syacct/Robo-DC-DC-Design/LM5143/LM(2)5143-Q1-dataDesign-19vout.xlsm

Sheet: Design Regulator
LM(2)5143/-Q1 Synchronous Buck Controller Design Tool
 |  |  |  |  |  |  |  |  |  |  |  |  | http://www.ti.com/product/lm5175
About |  | xx (http://www.ti.com/pol) |  |  | = Input Box |  |  |  |  |  |  |  | TERMS OF USE
Step 1: Operating Specifications
 |  |  | Input Voltage – Min, VIN(min) | 24 | V
 |  |  | Input Voltage – Nom, VIN(nom) | 48 | V
 |  |  | Input Voltage – Max, VIN(max) | 54 | V
 |  |  | Output Voltage, VOUT | 24 | V |  |  | Output Voltage, VOUT2 | 24 | V
 |  |  | Full Load Output Current, IOUT | 20 | A |  |  | Full Load Output Current, IOUT2 | 20 | A
 |  |  | Switching Frequency, FSW | 200 | kHz
 |  |  | Frequency Set Resistor, RT | 110 | kΩ
 |  |  | Ambient Temperature, TA | 25 | °C
Step 2: Current Sense Resistors
 |  |  | Required IOCP Setpoint at VIN(nom) | 16 | A |  |  | Required IOCP Setpoint at VIN(nom) | 16 | A
 |  |  | Recommended Sense Resistance | 6.6 | mΩ |  |  | Recommended Sense Resistance | 3.8 | mΩ
 |  |  | Sense Resistance, RS | 2 | mΩ |  |  | Sense Resistance, RS2 | 2 | mΩ
 |  |  | Min Inductor Sat Current, ILO(SAT) | 36.5 | A |  |  | Min Inductor Sat Current, ILO2(SAT) | 36.5 | A
 |  |  | Max power loss in shunt | 2.66 | W |  |  | Max power loss in shunt RS2 | 2.66 | W
 |  |  | VIN(min) | 73.0 | A |  |  | VIN(min) | 36.5 | A
 |  | IOUT(typ) at OCP Inception: | VIN(nom) | 67.0 | A |  | IOUT2(typ) at OCP Inception: | VIN(nom) | 33.5 | A
 |  |  | VIN(max) | 66.3 | A |  |  | VIN(max) | 33.2 | A
Step 3: Buck Inductances
 |  |  | Ch1 Recommended Inductance | 10.00 | µH |  |  | Ch2 Recommended Inductance | 10.00 | µH
 |  |  | Ch1 Inductance, LO1 | 10 | µH |  |  | Ch2 Inductance, LO2 | 10 | µH
 |  |  | Ch1 Inductor DCR | 3.5 | mΩ |  |  | Ch2 Inductor DCR | 3.5 | mΩ
 |  |  | DIL as a % at VIN(nom) | 60.11245314 | % |  |  | DIL2 as a % at VIN(nom) | 30.11240633 | %
Step 4: Output Capacitors
 |  |  | Output Voltage Ripple Spec | 70 | mVpk-pk |  |  | Ch2 Output Voltage Ripple Spec | 50 | mVpk-pk
 |  |  | Minimum Output Capacitance | 53.7 | µF |  |  | Ch2 Minimum Output Capacitance | 75.3 | µF
 |  |  | Output Capacitance (derated), COUT | 900 | µF |  |  | Ch2 Output Cap (derated), COUT2 | 490 | µF | ** For Single-Output Operation in 2-Phase Mode, tie MODE to VDDA and use FB1 to set VOUT **
 |  |  | Maximum Permitted ESR | 11.62411651 | mΩ |  |  | Ch2 Maximum Permitted ESR | 8.203659474 | mΩ
 |  |  | Output Capacitor ESR | 10 | mΩ |  |  | Ch2 Output Capacitor ESR | 2 | mΩ | ** Tie VCCX to GND if not used **
 |  |  | Resulting Output Voltage Ripple (max) | 60.25722589 | mVpk-pk |  |  | Resulting Output Voltage Ripple (max) | 14.28601397 | mVpk-pk
 |  |  | Output Capacitor RMS Current (max) | 1.93 | A (rms) |  |  | Output Capacitor RMS Current (max) | 1.93 | A (rms)
Step 5: Input Capacitors
 |  |  | Input Voltage Ripple Spec | 100 | mVpk-pk
 |  |  | Minimum Input Capacitance | 250 | µF
 |  |  | Input Capacitance, CIN | 440 | µF
 |  |  | Maximum Permitted ESR | 5.4 | mΩ
 |  |  | Input Capacitor ESR | 1 | mΩ
 |  |  | Resulting Input Voltage Ripple (max) | 41.74882619 | mVpk-pk
 |  |  | Input Capacitor RMS Current (max) | 5.00 | A (rms)
Step 6: Soft-start, Hiccup, Dither, DEMB, MODE
 |  |  | Soft-Start Time, tSS | 15 | ms
 |  |  | Soft-Start Capacitance, CSS | 470 | nF
 |  |  | Hiccup Fault Time, tRES | 30 | ms
 |  |  | RES Capacitance, CRES | 470 | nF
 |  |  | Modulating Frequency | 9
 |  |  | *Tie DITH to VDDA
 |  |  | * Tie DEMB to VDDA
 |  |  | * Tie MODE to VDDA
Step 7: Compensation Design
 |  |  | Load Pole Frequency | 236.3451179 | Hz |  |  | Ch2 Load Pole Frequency | 352.0818137 | Hz
 |  |  | ESR Zero Frequency | 17.68388259 | kHz |  |  | Ch2 ESR Zero Frequency | 162.4030033 | kHz
 |  |  | Desired Crossover Frequency | 20 | kHz |  |  | Ch2 Desired Crossover Frequency | 20 | kHz
 |  |  | Error Amp Pole Frequency | 1.4 | Hz |  |  | Ch2 Error Amp Pole Frequency | 1.7 | Hz
 |  |  | Upper Feedback Resistor | 51 | kΩ |  |  | Ch2 Upper Feedback Resistor | 51 | kΩ
 |  |  | Lower Feedback Resistor | 1.3 | kΩ |  |  | Ch2 Lower Feedback Resistor | 1.3 | kΩ
Compensation Components
 | Calculated / | Std Values | Std Values |  | Actual P/Z Frequencies
RC1 | 45.2 | 45.3 | 45.3 | kΩ | 1.380576138 | Hz (FPEA)
CC1 | 1.8 | 1.8 | 1.8 | nF | 2.0 | kHz (FZCOMP)
CC2 | 192.5774814 | 180 | 180 | pF | 18.85188515 | kHz (FPCOMP)
RC2 | 49.3 | 48.7 | 48.7 | kΩ | 1.656603421 | Hz (FPEA2)
CC3 | 1.6 | 1.5 | 1.5 | nF | 2.2 | kHz (FZCOMP2)
CC4 | 25.94285325 | 27 | 27 | pF | 97.94549192 | kHz (FPCOMP2) |  |  |  |  |  | ** Specify Inductor Core Loss ** | 0.3 | W
Efficiency / Power Loss Analyzer
Step 8: Efficiency
 |  |  |  |  | Power MOSFETs | (Q1, Q2) |  | Power MOSFETs | (Q3, Q4)
 |  |  |  | NVMFS5H663, NVMFS5C628NL |  |  | NVMFS5H663, NVMFS5C628NL
 |  |  |  | High-side | Low-side |  | High-side | Low-side
 |  |  | On-State Resistance, RDS(on) | 2.5 | 2.5 | mΩ | 6 | 2.5 | mΩ
 |  |  | Total Gate Charge, QG | 45 | 45 | nC | 8 | 25 | nC
 |  |  | Gate-Drain Charge, QGD | 15 | 15 | nC | 1.4 | 4.5 | nC
 |  |  | Gate-Source Charge, QGS | 16 | 16 | nC | 3.8 | 12 | nC
 |  |  | Output Charge, QOSS |  | 88 | nC |  | 30 | nC
 |  |  | Output Capacitance, COSS | 840 | 840 | pF | 213 | 1700 | pF
 |  |  | Gate Resistance, RG | 1.7 | 1.7 | Ω | 0.5 | 0.5 | Ω
 |  |  | Transconductance, gFS | 140 | 140 | S | 64 | 280 | S
 |  |  | Gate-Source Threshold Voltage, VTH | 1.7 | 1.7 | V | 2.9 | 3 | V
 |  |  | Body Diode Forward Voltage, VBD | 0.85 | 0.85 | V | 0.7 | 0.7 | V
 |  |  | Body Diode Rev Recovery Charge, QRR |  | 47 | nC |  | 60 | nC
 |  |  | Thermal Resistance, θJA | 50 | 50 | °C/W | 50 | 38 | °C/W
External Schottky Diode (if applicable)
 |  |  | Schottky Fwd Voltage, VFWDsch | 0 | 0 | V
 |  |  | Schottky Rev Recovery Charge, QRRsch | 0 | 0 | nC
Step 9: IC Power Loss
 |  |  | IC Power Dissipation | 0.18 | W
 |  |  | IC Junction Temperature (estimate) | 31.3 | °C

Sheet: BOM & Schematic
** Tie DEMB to VDDA for FPWM, AGND for DCM ** |  |  |  |  |  | ** Tie VCCX to GND if not used **
** Tie MODE to VDDA for Single, AGND for Dual Outputs **
** For Dual-Output Operation, tie FB1/FB2 to to VDDA for Fixed 3.3V, AGND for Fixed 5V Output **
** For Single-Output Operation in 2-Phase Mode, tie MODE to VDDA and use FB1 to set VOUT. Connect FB2 to AGND to disable EA of channel 2 **
** For Single-Output Operation in 3-Phase or 4-Phase Mode, tie all MODE pins to VDDA. Use FB1 of master IC to set VOUT. Connect FB2 of master IC to AGND. Connect FB2 of slave IC to VDDA to configure it as a slave **
VIN = 24 V to 54 V, VOUT = 24 V, IOUT = 20 A, Fsw = 200 kHz, Current Limit = 16 A
High Efficiency Synchronous Buck Regulator BOM
Count | Ref Des | Value | Description |  | Size | Part Number | MFR
2 | CBOOT1, CBOOT2 | 0.1µF | Capacitor, Ceramic,0.1-µF, 25V, X7R, 20% |  | 0603 | Std | Std
1 | CC1 | 1.8nF | Capacitor, Ceramic,1.8-nF, 16V, X7R, 10% |  | 0603 | Std | Std
1 | CC2 | 180pF | Capacitor, Ceramic,180-pF, 50V, NP0, 5% |  | 0603 | Std | Std
1 | CC3 | N/A | N/A |  | - | - | -
1 | CC4 | N/A | N/A |  | - | - | -
1 | CRES | 470nF | Capacitor, Ceramic,470-nF, 16V, X7R, 10% |  | 0603 | Std | Std
1 | CDITH | 10nF | Capacitor, Ceramic,10-nF, 16V, X7R, 10% |  | 0603 | Std | Std
44 | CIN | 10µF | Capacitor, Ceramic,10-µF, 50V, X7R, 20% |  | 1210 | Std | Std
20 | COUT | 47µF | Capacitor, Ceramic,47-µF, 10V, X7R, 20% |  | 1210 | Std | Std
2 | CSS1, CSS2 | 470nF | Capacitor, Ceramic,470-nF, 16V, X7R, 10% |  | 0603 | Std | Std
3 | CVCC1, CVCC2, CVCCX | 2.2µF | Capacitor, Ceramic,2.2-µF, 25V, X7R, 20% |  | 0603 | Std | Std
1 | CVDDA | 0.47µF | Capacitor, Ceramic,0.47-µF, 25V, X7R, 20% |  | 0603 | Std | Std
2 | DBOOT1, DBOOT2 | See description | Schottky Diode, 60V, 200mA |  | - | - | Various
1 | LO1 | 10µH | Inductor, 10µH, 3.5mΩ, >11A |  | - | - | Various
1 | LO2 | 10µH | Inductor, 10µH, 3.5mΩ, >11A |  | - | - | Various
2 | Q1, Q2 | See description | MOSFET, N-CH, 40V,2.5mΩ |  | Std | NVMFS5H663, NVMFS5C628NL | -
2 | Q3, Q4 | See description | MOSFET, N-CH, 40V,6mΩ |  | Std | NVMFS5H663, NVMFS5C628NL | -
1 | RC1 | 45.3k | Resistor, Chip,45.3-kΩ, 1/16W, 1% |  | 0603 | Std | Std
1 | RC2 | N/A | N/A |  | - | - | -
1 | RS1 | 2m | Resistor, Chip,2-mΩ, 2W, 1% |  | 0508 | Std | Std
1 | RS2 | 2m | Resistor, Chip,2-mΩ, 2W, 1% |  | 0508 | Std | Std
1 | RT | 110k | Resistor, Chip,110-kΩ, 1/16W, 1% |  | 0603 | Std | Std
1 | RFB1 | 51k | Resistor, Chip,51-kΩ, 1/16W, 1% |  | 0603 | Std | Std
1 | RFB2 | 1.3k | Resistor, Chip,1.3-kΩ, 1/16W, 1% |  | 0603 | Std | Std
1 | RFB3 | N/A | N/A |  | - | - | -
1 | RFB4 | N/A | N/A |  | - | - | -
2 | RPGOOD1, RPGOOD2 | 100k | Resistor, Chip,100-kΩ, 1/16W, 1% |  | 0603 | Std | Std
2 | RPG1, RPG2 | 100k | Resistor, Chip,100-kΩ, 1/16W, 1% |  | 0603 | Std | Std
1 | RDEMB | 100k | Resistor, Chip,100-kΩ, 1/16W, 1% |  | 0603 | Std | Std
1 | RVIN | 2.2 | Resistor, Chip,2.2-Ω, 1/16W, 1% |  | 0603 | Std | Std
1 | U1 | LM5143 | IC, LM5143, Buck PWM Controller, 3.5V–65V Input |  | VQFN-40 | LM5143RHAR | TI
NOTES:
** For information on TI NexFETTM MOSFETs, see ** |  |  | http://www.ti.com/nexfet | **
** Inductor saturation current should be higher than the peak inductor current at the OCP setpoint for all input voltages and operating temperatures **
** Effective input and output capacitances should be appropriately derated for applied voltage and temperature, particularly with ceramics **

Sheet: EVM
LM(2)5143/-Q1 Quickstart Design Tool
 | LM5143-Q1EVM-2100 PCB Layout
