syacct/Robo-DC-DC-Design/LM5145/LM5145contorller-dataDesign-48to24v.xlsm

Sheet: Design Regulator
LM(2)5145/46-Q1 DC-DC Controller Design Tool
About |  | xx (http://www.ti.com/pol) |  |  | = Input Box |  |  |  |  | TERMS OF USE
Step 1: Operating Specifications
 |  |  | Input Voltage ‒ Min, VIN(min) | 40 | V
 |  |  | Input Voltage ‒ Nom, VIN(nom) | 48 | V
 |  |  | Input Voltage ‒ Max, VIN(max) | 60 | V
 |  |  | Output Voltage, VOUT | 24.7 | V
 |  |  | Maximum Output Current, IOUT | 20 | A
 |  |  | Free-running Switching Frequency, FSW | 120 | kHz
 |  |  | SYNC Frequency (if used), FSW-SYNC |  | kHz
 |  |  | Frequency Set Resistor, RRT | 82.5 | kΩ
Step 2: Filter Inductor
 |  |  | Recommended Filter Inductance | 15.0 | µH
 |  |  | Inductance, LF | 10 | µH
 |  |  | Inductor DCR | 2 | mΩ
 |  |  | Pk-to-Pk Ripple Current at VIN(nom), DIL | 10.0 | Apk-pk
 |  |  | Inductor Ripple Current as a % of Max IOUT | 50.16926459 | %
Step 3: RDS(on) or Shunt-Based Current Limit
 |  |  | Shunt, RS | 6 | mΩ |  |  |  |  |  | \
 |  |  | Required Current Limit Setpoint | 20 | A
 |  |  | Current Limit Set Resistor, RILIM | 215 | Ω
 |  |  | Min Inductor Sat Current, IL(SAT) | 30.0 | A
 |  |  | Power Loss in RS at Full Load, Max VIN | 0.83 | W
Step 4: Output Capacitance
 |  |  | Output Voltage Ripple Specification | 100 | mVpk-pk
 |  |  | Minimum Ideal Output Capacitance | 104.5193012 | µF
 |  |  | Total Output Capacitance (Derated), COUT | 457.5 | µF
 |  |  | Maximum Permitted ESR | 9.702692449 | mΩ
 |  |  | Output Capacitor ESR | 1 | mΩ
 |  |  | Resulting Output Voltage Ripple | 24.95208303 | mVpk-pk
 |  |  | Output Capacitor Ripple Current | 2.9 | A (rms)
Step 5: Input Capacitance
 |  |  | Input Voltage Ripple Specification | 480 | mVpk-pk
 |  |  | Minimum Ideal Input Capacitance | 86.70796396 | µF
 |  |  | Total Input Capacitance (Derated), CIN | 117.5 | µF
 |  |  | Maximum Permitted ESR | 5.028145371 | mΩ
 |  |  | Input Capacitor ESR | 1 | mΩ
 |  |  | Resulting Input Voltage Ripple | 379.2281835 | mVpk-pk
 |  |  | Input Capacitor Ripple Current | 10.0 | A (rms)
Step 6: Soft-start, UVLO
 |  |  | Soft-Start Time, tSS | 35 | ms
 |  |  | Soft-Start Capacitance, CSS | 470 | nF
 |  |  | Input Voltage UVLO Turn-On | 32.5 | V
 |  |  | Input Voltage UVLO Turn-Off | 30.5 | V
 |  |  | UVLO Upper Resistor, RUV1 | 200 | kΩ
 |  |  | UVLO Lower Resistor, RUV2 | 7.68 | kΩ
If the SYNC feature is not required, connect SYNCIN to GND
or VCC for DCM or CCM operation, respectively
Step 7: Compensation Design
 |  |  | LC Complex Pole Frequency | 2.4 | kHz
 |  |  | ESR Zero Frequency | 347.8796574 | kHz
 |  |  | Desired Crossover Frequency | 8 | kHz
 |  |  | Appropriate Midband Gain | 0.23 | V/V
 |  |  | Upper Feedback Resistor, RFB1 | 300 | kΩ
 |  |  | Lower Feedback Resistor, RFB2 | 10 | kΩ
 |  |  | Actual Output Voltage, VOUT | 24.800 | V
Pole & Zero Placement |  |  | FZ1 | 1.6 | kHz
Baseline P/Z Frequencies: |  |  | FZ2 | 2.1 | kHz
 |  |  | FP1 | 347.8796574 | kHz
 |  |  | FP2 | 60 | kHz
Compensation Components
 | Calculated / | Std Values | Selected |  | Actual P/Z Frequencies
RC1 | 68.0 | 68.1 | 68.1 | kΩ | 1.6 | kHz (FZ1)
CC1 | 1421.026279 | 1500 | 1500 | pF | 2.0 | kHz (FZ2)
CC2 | 40.12757695 | 39 | 39 | pF | 327.4793071 | kHz (FP1)
RC2 | 1838.179194 | 1820 | 1800 | Ω | 61.48310245 | kHz (FP2)
CC3 | 248.8875956 | 270 | 270 | pF |  |  | ** Specify Inductor Core Loss ** | 0.5 | W
Efficiency / Power Loss Analyzer
Step 8: Efficiency
 |  |  | High-Side MOSFET (Q1) Specifications | CSD19534Q5A*2
 |  |  | On-State Resistance, RDS(on) | 3.55 | mΩ
 |  |  | Total Gate Charge, QG | 22 | nC
 |  |  | Gate-Drain Charge, QGD | 7.8 | nC
 |  |  | Gate-Source Charge, QGS | 8.6 | nC
 |  |  | Output Capacitance, COSS | 440 | pF
 |  |  | Gate Resistance, RG | 0.6 | Ω
 |  |  | Transconductance, gFS | 94 | S
 |  |  | Gate-Source Threshold Voltage, VGS(TH) | 1.6 | V
 |  |  | Body Diode Forward Voltage, VBD1 | 0.86 | V
 |  |  | Thermal Resistance, θJA | 25 | °C/W
 |  |  | Low-Side MOSFET (Q2) Specifications | CSD19502Q5B
 |  |  | On-State Resistance, RDS(on) | 2.9 | mΩ
 |  |  | Total Gate Charge, QG | 70 | nC
 |  |  | Output Charge, QOSS | 91 | nC
 |  |  | Output Capacitance, COSS | 770 | pF
 |  |  | Body Diode Forward Voltage, VBD2 | 0.82 | V
 |  |  | Body Diode Recovery Charge, QRR | 122 | nC
 |  |  | Thermal Resistance, θJA | 50 | °C/W
 |  |  | Antiparallel Schottky Diode (if applicable)
 |  |  | Schottky Diode Forward Voltage, VSD | 0.64 | V
 |  |  | Schottky Diode Recovery Charge, QRR2 | 100 | nC

Sheet: Schematic & BOM
 | ** Tie SYNCIN to VCC and GND for CCM and DCM operation, respectively **
VIN = 48 V, VOUT = 24.7 V, IOUT = 20 A, Fsw = 120 kHz, Current Limit = 20 A
Wide VIN, High Efficiency Synchronous Buck Regulator BOM
Count | Ref Des | Value | Description | Size | Part Number | MFR | Footprint (mm) | Area (mm2)
1 | CBOOT | 0.1µF | Capacitor, Ceramic,0.1µF, 25V, X7R, 20% |  | Std | Std | 1.6 x 0.8 | 1.3 |  |  |  | 2
1 | CC1 | 1500pF | Capacitor, Ceramic,1500pF, 16V, X7R, 10% |  | Std | Std | 1.0 x 0.5 | 0.5 |  |  |  | 1
1 | CC2 | 39pF | Capacitor, Ceramic,39pF, 50V, NP0, 5% |  | Std | Std | 1.0 x 0.5 | 0.5 |  |  |  | 1
1 | CC3 | 270pF | Capacitor, Ceramic,270pF, 50V, NP0, 5% |  | Std | Std | 1.0 x 0.5 | 0.5 |  |  |  | 1
1 | CS | 27pF | Capacitor, Ceramic, 27pF, 100V, X7R, 20% |  | Std | Std | 1.6 x 0.8 | 1.3 |  |  |  | 2
12 | CIN | 4.7µF | Capacitor, Ceramic, 4.7µF, 100V, X7S, 10% |  | Std | Std | 3.2 x 2.5 | 96.0 |  |  |  | 5
46 | COUT | 10µF | Capacitor, Ceramic, 10µF, 50V, X7R, 10% |  | Std | Std | 3.2 x 2.5 | 368.0 |  |  |  | 5
1 | CSS | 470nF | Capacitor, Ceramic,470nF, 16V, X7R, 10% |  | Std | Std | 1.6 x 0.8 | 1.3 |  |  |  | 2
1 | CVCC | 2.2µF | Capacitor, Ceramic,2.2µF, 25V, X7R, 20% |  | Std | Std | 2.0 x 1.25 | 2.5 |  |  |  | 3
1 | CVIN | 0.1µF | Capacitor, Ceramic,0.1µF, 50V, X7R, 20% |  | Std | Std | 1.6 x 0.8 | 1.3 |  |  |  | 2
1 | LF | 10µH | Inductor, 10µH, 2mΩ, >30A |  | Various | Various | 10.0 x 10.0 | 100.0 |  |  |  | 7
1 | Q1 | See description | MOSFET, N-CH, 80V/100V,3.55mΩ |  | CSD19534Q5A*2 | TI | 5.0 x 6.0 | 30.0 |  |  |  | 1 | 1
1 | Q2 | See description | MOSFET, N-CH, 80V/100V,2.9mΩ |  | CSD19502Q5B | TI | 5.0 x 6.0 | 30.0 |  |  |  | 1 | 1
1 | RC1 | 68.1k | Resistor, Chip,68.1kΩ, 1/16W, 1% |  | Std | Std | 1.0 x 0.5 | 0.5 |  |  |  | 1
1 | RC2 | 1800 | Resistor, Chip,1800Ω, 1/16W, 1% |  | Std | Std | 1.0 x 0.5 | 0.5 |  |  |  | 1
1 | RILIM | 215 | Resistor, Chip,215Ω, 1/16W, 1% |  | Std | Std | 1.0 x 0.5 | 2.5 |  |  |  | 3
1 | RRT | 82.5k | Resistor, Chip,82.5kΩ, 1/16W, 1% |  | Std | Std | 1.0 x 0.5 | 0.5 |  |  |  | 1
1 | RFB1 | 300k | Resistor, Chip,300kΩ, 1/16W, 1% |  | Std | Std | 1.0 x 0.5 | 0.5 |  |  |  | 1
1 | RFB2 | 10k | Resistor, Chip,10kΩ, 1/16W, 1% |  | Std | Std | 1.0 x 0.5 | 0.5 |  |  |  | 1
1 | RPGOOD | 20k | Resistor, Chip,20kΩ, 1/16W, 1% |  | Std | Std | 1.0 x 0.5 | 0.5 |  |  |  | 1
1 | RS | 6mΩ | Resistor,6mΩ, 1/4W, 1% | 1206 | Std | Std | 3.2 x 1.6 | 0.0
1 | RUV1 | 200k | Resistor, Chip,200kΩ, 1/16W, 1% |  | Std | Std | 1.6 x 0.8 | 1.3 |  |  |  | 2
1 | RUV2 | 7.68k | Resistor, Chip,7.68kΩ, 1/16W, 1% |  | Std | Std | 1.0 x 0.5 | 0.5 |  |  |  | 1
1 | RVIN | 2.2 | Resistor, Chip,2.2Ω, 1/16W, 1% |  | Std | Std | 1.0 x 0.5 | 0.5 |  |  |  | 1
1 | U1 | LM5145 | IC, LM5145, PWM Controller, 6V-75V Input | VQFN-20 | LM5145RGYR | TI | 3.5 x 4.5 x 1.0 | 15.75
 |  |  |  |  | Total Solution Size (buffered by 25%) |  |  | 820.9 | mm2 = | 1.2725 | in2
NOTES:
** Inductor saturation current should be higher than the current limit setpoint at all operating temperatures **
** Effective output capacitance should be appropriately derated for applied voltage and temperature, particularly with ceramics **
 |  |  |  |  |  |  |  |  |  |  |  | 2

Sheet: EVMs
LM(2)5145/6/-Q1 Quickstart Calculator
 | LM5146-Q1-EVM12V
 | LM5145EVM-HD-20A PCB Layout
 |  | Top
 |  | Layer | x
 |  | Layer 2
 |  | Layer 3
 |  | Bottom
