syacct/Robo-DC-DC-Design/LM5176/LM5176_Buck-Boost_dataDesign_19vout.xlsm

Sheet: Design Converter
LM5176 DC/DC Controller Design Tool
 |  |  |  |  |  |  |  |  |  |  |  | http://www.ti.com/product/lm5176
About |  | xx (http://www.ti.com/pol) |  |  | = Input Box |  |  |  |  |  |  | TERMS OF USE
Step 1: Operating Specifications |  |  |  |  |  |  |  |  | V 1.0.2 | February 2026
 |  |  | Input Voltage - Min, VIN(min) | 12 | V
 |  |  | Input Voltage - Nom, VIN(nom) | 24 | V
 |  |  | Input Voltage - Max, VIN(max) | 36 | V
 |  |  | Output Voltage, VOUT | 19 | V
 |  |  | Full Load Output Current, IOUT(max) | 8 | A
 |  |  | Switching Frequency | 300 | kHz
 |  |  | Frequency Set Resistor, RT | 27.4 | kΩ
Step 2: Filter Inductor
 |  |  | Recommended Filter Inductance | 4.1 | µH
 |  |  | Inductance, LF | 10 | µH
 |  |  | Inductor DCR | 10 | mΩ
 |  |  | Pk-to-Pk Ripple Current at VIN(min), DIL1 | 1.5 | Apk-pk
 |  |  | Pk-to-Pk Ripple Current at VIN(nom), DIL2 | 1.3 | Apk-pk
 |  |  | Pk-to-Pk Ripple Current at VIN(max), DIL3 | 3.0 | Apk-pk
 |  |  | DIL as a % at VIN(min) | 10.7211484 | %
 |  |  | DIL as a % at VIN(nom) | 16.56960621 | %
 |  |  | DIL as a % at VIN(max) | 37.57861635 | %
Step 3: OCP, Sense Resistors, Slope Comp
 |  |  | Required IOCP(MIN) Setpoint at VIN(nom) | 8 | A
 |  |  | Recommended Sense Resistance | 8.1 | mΩ
 |  |  | Sense Resistance, RS | 5 | mΩ
 |  |  | Peak Inductor Current, ILPK | 24.0 | A
 |  |  | Power Loss in Rs at Full Load (Min VIN) | 0.37 | W
 |  |  | Recommended SLOPE Capacitance | 820 | pF
 |  |  | SLOPE Capacitance, CSLOPE | 820 | pF
 |  |  | VIN(min) | 14.5 | A
 |  | IOUT(typ) at OCP Inception: | VIN(nom) | 16.7 | A
 |  |  | VIN(max) | 17.5 | A
 |  |  | Set Const Current Loop Setpoint (?) | 10 | A
 |  |  | Output Leg Shunt Resistance, RCS(out) | 5 | mΩ
Step 4: Output Capacitor
 |  |  | Output Voltage Ripple Spec | 150 | mVpk-pk
 |  |  | Minimum Output Capacitance | 67.1 | µF
 |  |  | Output Capacitance, COUT | 260 | µF
 |  |  | Maximum Permitted ESR | 13.9 | mΩ
 |  |  | Output Capacitor ESR | 2 | mΩ
 |  |  | Resulting Output Voltage Ripple (max) | 54.68980429 | mVpk-pk
 |  |  | Output Capacitor RMS Current (max) | 6.1 | A (rms)
 |  |  |  |  |  |  |  |  |  | VIN(nom) | 24V
Step 5: Input Capacitor
 |  |  | Input Voltage Ripple Spec | 200 | mVpk-pk
 |  |  | Minimum Input Capacitance | 33.2 | µF
 |  |  | Input Capacitance, CIN | 260 | µF
 |  |  | Maximum Permitted ESR | 18.4 | mΩ
 |  |  | Input Capacitor ESR | 10 | mΩ
 |  |  | Resulting Input Voltage Ripple (max) | 120.5769265 | mVpk-pk
 |  |  | Input Capacitor RMS Current (max) | 4.0 | A (rms)
Step 6: Soft-start, Dither, UVLO
 |  |  | Soft-Start Time, tSS | 7 | ms
 |  |  | Soft-Start Capacitance, CSS | 47 | nF
 |  |  | Modulating Frequency | 1
 |  |  | *Short DITH pin to GND
 |  |  | Required Input Voltage UVLO On | 9.5 | V
 |  |  | Input Voltage UVLO Off | 9.28 | V
 |  |  | Upper UVLO Resistor, RUV1 | 51 | kΩ
 |  |  | Lower UVLO Resistor, RUV2 | 7.5 | kΩ
Step 7: Compensation Design
 |  |  | Load Pole Frequency | 376.3346281 | Hz
 |  |  | COUT ESR Zero Frequency | 306.0671986 | kHz
 |  |  | Boost RHP Zero Frequency | 1.583233698 | kHz
 |  |  | Desired Crossover Frequency | 18 | kHz
 |  |  | Error Amp Pole Frequency | 0.3614446966 | Hz
 |  |  | Upper Feedback Resistor, RFB1 | 75 | kΩ
 |  |  | Lower Feedback Resistor, RFB2 | 3.32 | kΩ
Compensation Components
 | Calculated / | Std Values | Selected |  | Actual P/Z Frequencies
RC | 13.7 | 13.7 | 15 | kΩ | 0.3614446966 | Hz (FPEA) | Min COMP Voltage | 1.49V
CC1 | 20.5 | 22 | 22 | nF | 0.5 | kHz (FZCOMP) | Max COMP Voltage | 2V
CC2 | 66.61478276 | 68 | 68 | pF | 113.7643614 | kHz (FPCOMP)
Efficiency / Power Loss Analyzer
Step 8: Efficiency |  |  |  |  |  |  |  |  |  | VIN(nom) | 24V
 |  |  | Buck-Leg Power MOSFETs (Q1, Q2) | CSD18563Q5A
 |  |  |  | Hi-side | Low-side
 |  |  | On-State Resistance, RDS(on) | 7.0 | 7.0 | mΩ
 |  |  | Total Gate Charge, QG | 11 | 11 | nC
 |  |  | Gate-Drain Charge, QGD | 2.9 | 2.9 | nC
 |  |  | Gate-Source Charge, QGS | 3.3 | 3.3 | nC
 |  |  | Gate Resistance, RG | 1.5 | 1.5 | Ω
 |  |  | Transconductance, gFS | 60 | 60 | S
 |  |  | Gate-Source Threshold Voltage, VTH | 4 | 4 | V
 |  |  | Body Diode Forward Voltage, VBD | 0.8 | 0.8 | V
 |  |  | Body Diode Rev Recovery Charge, QRR |  | 63 | nC
 |  |  | Thermal Resistance, θJA | 50 | 50 | °C/W
 |  |  | Boost-Leg Power MOSFETs (Q3, Q4) | CSD16321Q5
 |  |  |  | Hi-side | Low-side
 |  |  | On-State Resistance, RDS(on) | 7 | 7 | mΩ
 |  |  | Total Gate Charge, QG | 22 | 22 | nC
 |  |  | Gate-Drain Charge, QGD | 2.5 | 2.5 | nC
 |  |  | Gate-Source Charge, QGS | 4 | 4 | nC
 |  |  | Gate Resistance, RG | 1.5 | 1.5 | Ω
 |  |  | Transconductance, gFS | 150 | 150 | S
 |  |  | Gate-Source Threshold Voltage, VTH | 2 | 2 | V
 |  |  | Body Diode Forward Voltage, VBD | 0.8 | 0.8 | V
 |  |  | Body Diode Rev Recovery Charge, QRR | 33 |  | nC
 |  |  | Thermal Resistance, θJA | 50 | 50 | °C/W
External Schottky Diode (if applicable) |  |  |  | Buck Leg | Boost Leg
 |  |  | Schottky Fwd Voltage, VFWDsch | 0 | 0 | V
 |  |  | Schottky Rev Recovery Charge, QRRsch | 0 | 0 | nC

Sheet: BOM & Schematic
 | ** Tie MODE to VCC (or voltage > 2.4V) for No Hiccup **
VIN = 12 V to 36 V, VOUT = 19 V, IOUT = 8 A, Fsw = 300 kHz, Current Limit = 8 A
High Efficiency Synchronous Buck-Boost Regulator BOM
Count | Ref Des | Value | Description |  | Size | Part Number | MFR
2 | CBOOT1, CBOOT2 | 0.1µF | Capacitor, Ceramic,0.1-µF, 50V, X7R, 20% |  | 0603 | Std | Std
1 | CC1 | 22nF | Capacitor, Ceramic,22-nF, 16V, X7R, 10% |  | 0603 | Std | Std
1 | CC2 | 68pF | Capacitor, Ceramic,68-pF, 50V, NP0, 5% |  | 0603 | Std | Std
1 | CSLOPE | 820pF | Capacitor, Ceramic,820-pF, 50V, NP0, 5% |  | 0603 | Std | Std
1 | CCS | 100pF | Capacitor, Ceramic,100-pF, 16V, X7R, 10% |  | 0603 | Std | Std
1 | CDITH | 39nF | Capacitor, Ceramic,39-nF, 16V, X7R, 10% |  | 0603 | Std | Std
26 | CIN | 10µF | Capacitor, Ceramic,10-µF, 50V, X7R, 20% |  | 1210 | Std | Std
12 | COUT | 22µF | Capacitor, Ceramic,22-µF, 25V, X5R, 20% |  | 1210 | Std | Std
1 | CSS | 47nF | Capacitor, Ceramic,47-nF, 16V, X7R, 10% |  | 0603 | Std | Std
1 | CVCC | 1µF | Capacitor, Ceramic,1-µF, 25V, X7R, 20% |  | 0603 | Std | Std
1 | CVIN | 0.1µF | Capacitor, Ceramic,0.1-µF, 100V, X7R, 20% |  | 0603 | Std | Std
3 | DBOOT1, DBOOT2, DVIN | See description | Schottky Diode, 200mA |  | - | - | Various
1 | LF | 10µH | Inductor, 10µH, 10mΩ, >27A |  | - | - | Various
2 | Q1, Q2 | See description | MOSFET, N-CH, 60V,7mΩ |  | Std | CSD18563Q5A | -
2 | Q3, Q4 | See description | MOSFET, N-CH, 60V,7mΩ |  | Std | CSD16321Q5 | -
1 | RC1 | 15k | Resistor, Chip,15-kΩ, 1/16W, 1% |  | 0603 | Std | Std
1 | RS | 5m | Resistor, Chip,5-mΩ, 2W, 1% |  | 2512 | Std | Std
1 | RCS(out) | 4.99m | Resistor, Chip,4.99-mΩ, 2W, 1% |  | 2512 | Std | Std
1 | RT | 27.4k | Resistor, Chip,27.4-kΩ, 1/16W, 1% |  | 0603 | Std | Std
1 | RFB1 | 75k | Resistor, Chip,75-kΩ, 1/16W, 1% |  | 0603 | Std | Std
1 | RFB2 | 3.32k | Resistor, Chip,3.32-kΩ, 1/16W, 1% |  | 0603 | Std | Std
1 | RPGOOD | 20k | Resistor, Chip,20-kΩ, 1/16W, 1% |  | 0603 | Std | Std
2 | RCS, RCSG | 100 | Resistor, Chip,100-Ω, 1/16W, 1% |  | 0603 | Std | Std
1 | RUV1 | 51k | Resistor, Chip,51-kΩ, 1/16W, 1% |  | 0603 | Std | Std
1 | RUV2 | 7.5k | Resistor, Chip,7.5-kΩ, 1/16W, 1% |  | 0603 | Std | Std
1 | RVIN | 2.2 | Resistor, Chip,2.2-Ω, 1/16W, 1% |  | 0603 | Std | Std
1 | U1 | LM5176 | IC, LM5176, Buck-Boost PWM Controller |  | TSSOP-28 | LM5176PWP | TI
NOTES:
** For information on TI NexFETTM MOSFETs, see ** |  |  | http://www.ti.com/nexfet | **
** Inductor saturation current should be higher than the peak inductor current at the OCP setpoint for all input voltages and operating temperatures **
** Effective input and output capacitances should be appropriately derated for applied voltage and temperature, particularly with ceramics **

Sheet: Licenses
Version Number | 1.0.2
Version History
Version | Change List Description
1.0.0 | Initial Release
1.0.1 | Fixed display of comments, optimized proposal of inductor
1.0.2 | Fixed calculation of Peak Inductor Current, ILPK
