syacct/Robo-DC-DC-Design/LM5176/LM5176.step

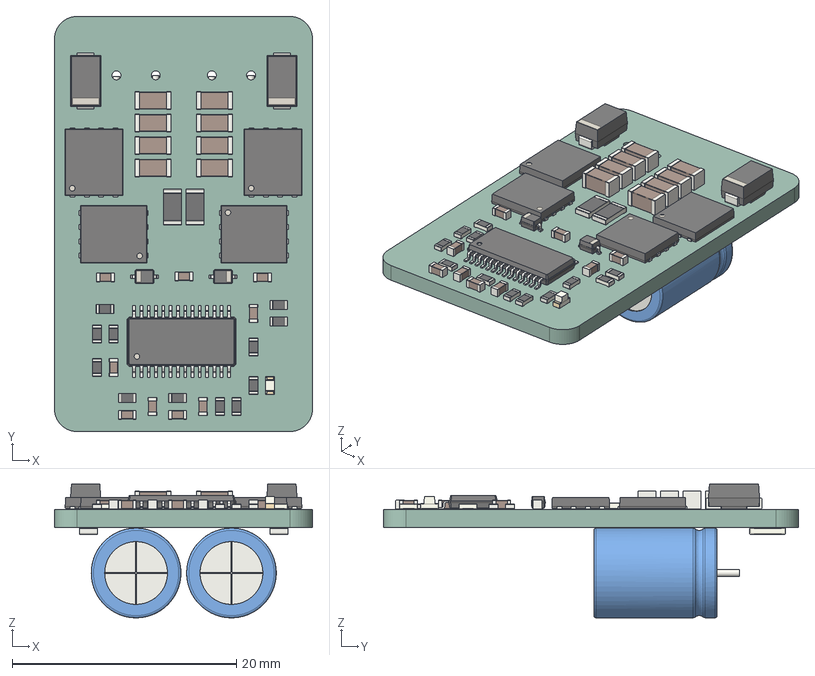
[picture p1: CAD file, 2026-10-31]
LM5176/LM5176.step
23.0 x 37.0 x 11.9 mm
C_1206_3216Metric x 8
R_0603_1608Metric x 12
D_SMA x 2
R_1206_3216Metric x 3
HTSSOP_28_1EP_44x97mm_P065mm
C_0603_1608Metric x 9
TDSON_8_1 x 4
D_SOD_323 x 2
LED_0603_1608Metric
C_Radial_D80mm_H115mm_P350mm x 2
Fuse_1206_3216Metric
LM5176_PCB
