syacct/Robo-DC-DC-Design/LM5145/LM5145_48-24.kicad_pcb

## KiCad design LM5145/LM5145_48-24.kicad_pcb (2026-10-31)

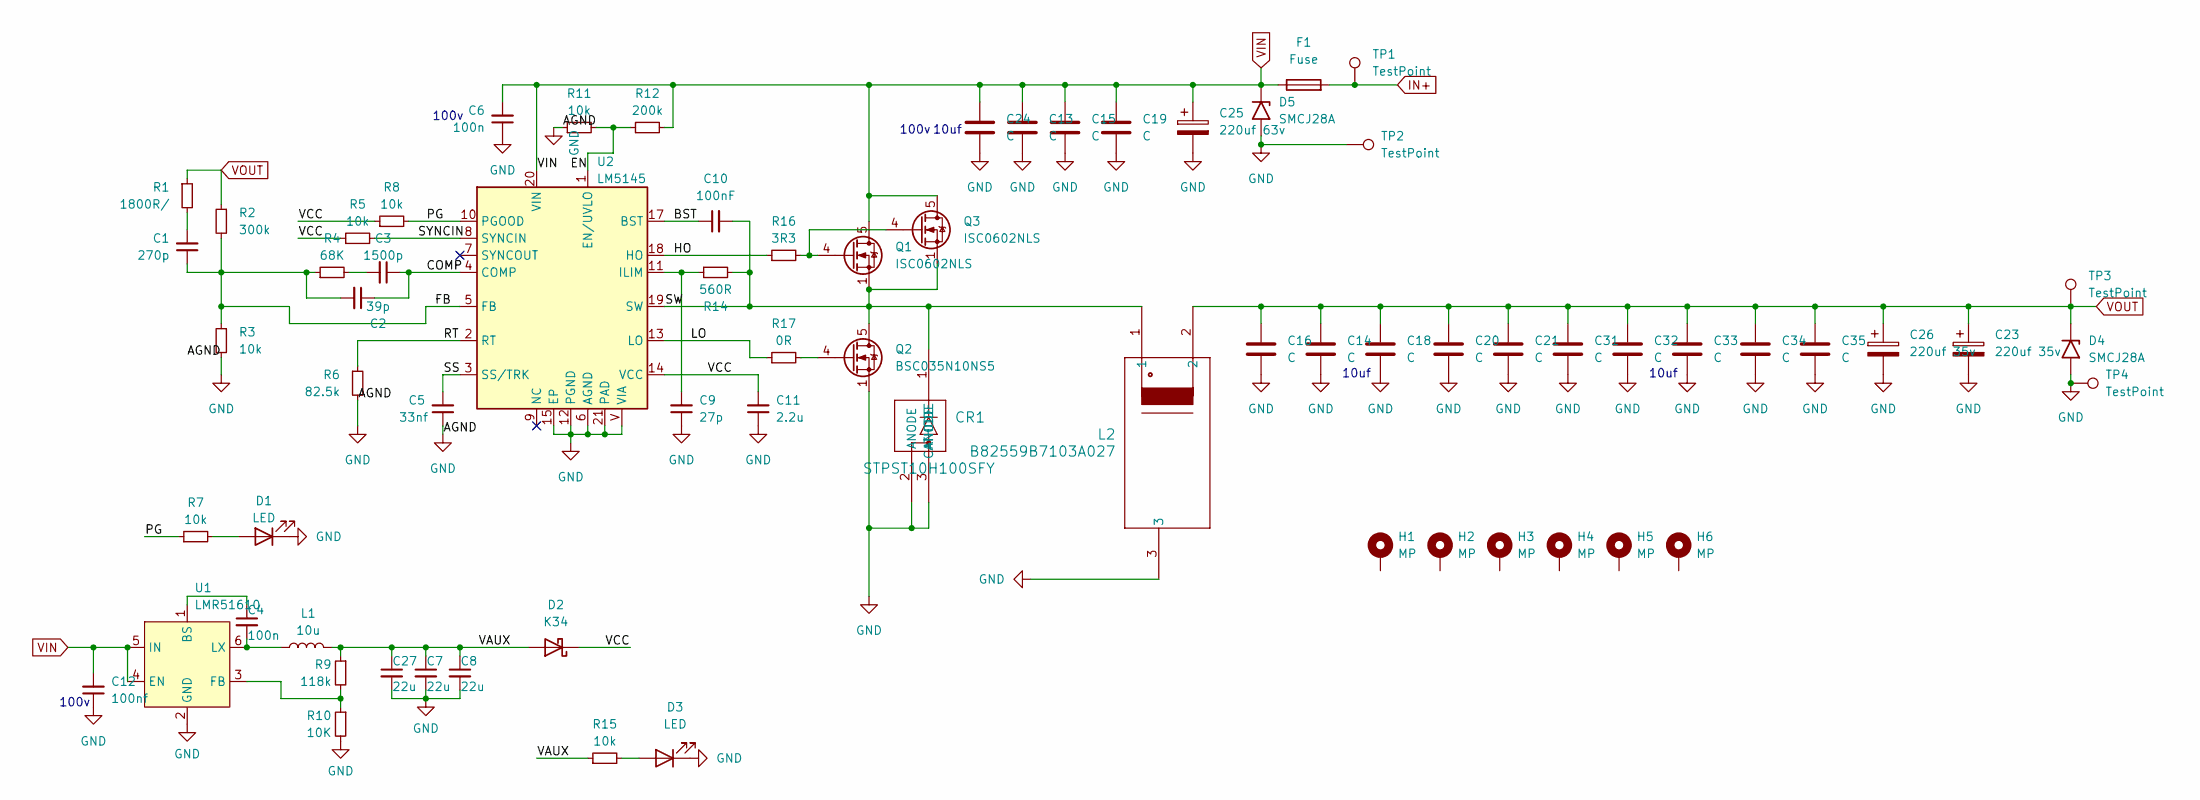
[picture p2: schematic LM5145_48-24.kicad_sch]

Parts:
C1: 270p; C_0603_1608Metric
C2: 39p; C_0603_1608Metric
C3: 1500p; C_0603_1608Metric
C4, C6: 100n; C_0603_1608Metric
C5: 33nf; C_0603_1608Metric
C7, C8, C27: 22u; C_0805_2012Metric
C9: 27p; C_0603_1608Metric
C10: 100nF; C_0603_1608Metric
C11: 2.2u; C_0603_1608Metric
C12: 100nf; C_0603_1608Metric
C13, C15, C19, C24: C; C_1210_3225Metric
C14, C16, C18, C20, C21, C31, C32, C33, C34, C35: C; C_1206_3216Metric
C23, C26: 220uf 35v; CP_Elec_8x10.5
C25: 220uf 63v; CP_Elec_8x10.5
CR1: STPST10H100SFY; PSMCTO-277A_STM
D1, D3: LED; LED_0603_1608Metric
D2: K34; D_SMF
D4, D5: SMCJ28A; D_SMC
F1: Fuse; Fuse_Littelfuse-NANO2-451_453
H1, H2, H3, H4, H5, H6: MP; MountingHole_2.7mm_M2.5_DIN965_Pad
L1: 10u; L_Sunlord_MWSA0402S
L2: B82559B7103A027; L_PR27XX
Q1, Q3: ISC0602NLS; TDSON-8-1
Q2: BSC035N10NS5; TDSON-8-1
R1: 1800R/; R_0603_1608Metric
R2: 300k; R_0603_1608Metric
R3, R5, R7, R8, R11, R15: 10k; R_0603_1608Metric
R4: 68K; R_0603_1608Metric
R6: 82.5k; R_0603_1608Metric
R9: 118k; R_0603_1608Metric
R10: 10K; R_0603_1608Metric
R12: 200k; R_0603_1608Metric
R14: 560R; R_0603_1608Metric
R16: 3R3; R_0603_1608Metric
R17: 0R; R_0603_1608Metric
TP1, TP2, TP3, TP4: TestPoint; TestPoint_Pad_3.0x3.0mm
U1: LMR51610; SOT-23-6
U2: LM5145; RGY0020B

Connections:
/BST: C10.1, U2.17 (BST)
/COMP: C2.1, C3.1, U2.4 (COMP)
/EN: R11.2, R12.1, U2.1 (EN/UVLO)
/FB: C1.1, C2.2, R2.2, R3.1, R4.1, U2.5 (FB)
/HO: R16.1, U2.18 (HO)
/LO: R17.1, U2.13 (LO)
/PG: R7.1, R8.2, U2.10 (PGOOD)
/RT: R6.1, U2.2 (RT)
/SS: C5.2, U2.3 (SS/TRK)
/SW: C10.2, CR1.1 (CATHODE), L2.1, Q1.1 (S), Q1.2 (S), Q1.3 (S), Q2.5 (D), Q3.1 (S), Q3.2 (S), Q3.3 (S), R14.2, U2.19 (SW)
/SYNCIN: R5.2, U2.8 (SYNCIN)
/VAUX: C7.1, C8.1, C27.1, D2.2 (A), L1.2, R9.1, R15.1
/VCC: C11.2, D2.1 (K), R5.1, R8.1, U2.14 (VCC)
GND: C5.1, C6.1, C7.2, C8.2, C9.1, C11.1, C12.1, C13.2, C14.2, C15.2, C16.2, C18.2, C19.2, C20.2, C21.2, C23.2, C24.2, C25.2, C26.2, C27.2, C31.2, C32.2, C33.2, C34.2, C35.2, CR1.2 (ANODE), CR1.3 (ANODE), D1.1 (K), D3.1 (K), D4.2 (A2), D5.2 (A2), L2.3, Q2.1 (S), Q2.2 (S), Q2.3 (S), R3.2, R6.2, R10.2, R11.1, TP2.1, TP4.1, U1.2 (GND), U2.6 (AGND), U2.12 (PGND), U2.15 (EP), U2.21 (PAD), U2.V (VIA)
IN+: F1.2, TP1.1
unnamed: C1.2, R1.2
unnamed: C3.2, R4.2
unnamed: D1.2 (A), R7.2
unnamed: D3.2 (A), R15.2
unnamed: Q1.4 (G), Q3.4 (G), R16.2
unnamed: Q2.4 (G), R17.2
unnamed: C4.1, U1.1 (BS)
unnamed: R9.2, R10.1, U1.3 (FB)
unnamed: C4.2, L1.1, U1.6 (LX)
unnamed: C9.2, R14.1, U2.11 (ILIM)
VIN: C6.2, C12.2, C13.1, C15.1, C19.1, C24.1, C25.1, D5.1 (A1), F1.1, Q1.5 (D), Q3.5 (D), R12.2, U1.4 (EN), U1.5 (IN), U2.20 (VIN)
VOUT: C14.1, C16.1, C18.1, C20.1, C21.1, C23.1, C26.1, C31.1, C32.1, C33.1, C34.1, C35.1, D4.1 (A1), L2.2, R1.1, R2.1, TP3.1

Notes on the sheet:
100v
10uf

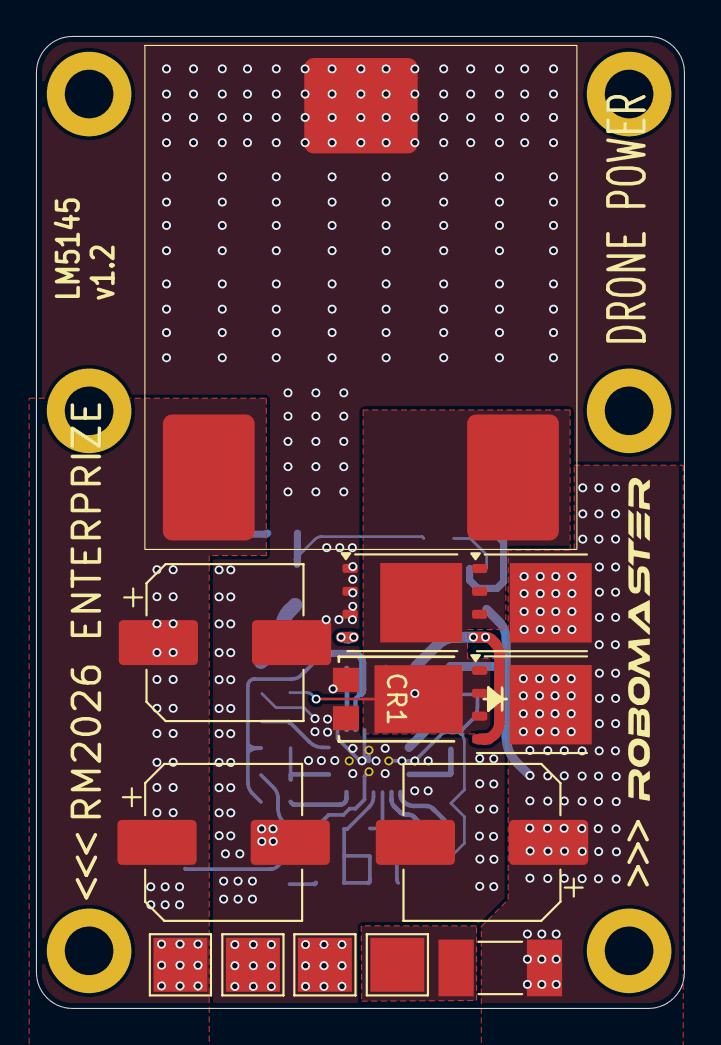
[picture p3: board LM5145_48-24.kicad_pcb from above]

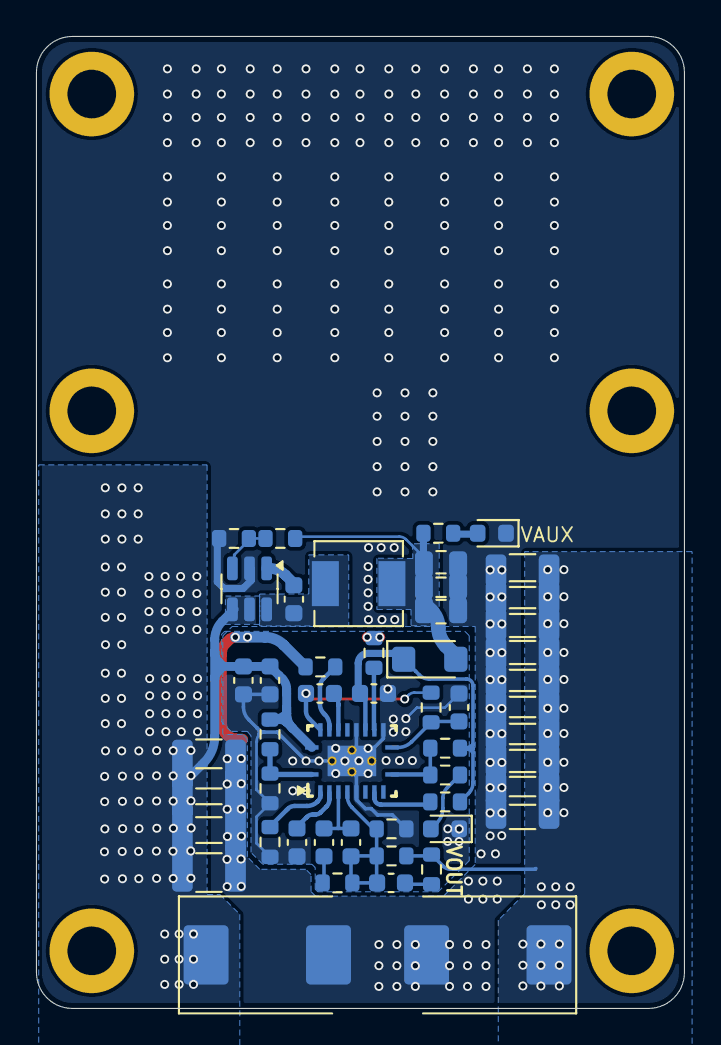
[picture p4: board LM5145_48-24.kicad_pcb from below]

Board: 2 copper layers, 36.0 x 54.0 mm, 70 parts (51 on the bottom side), 27 nets.
