syacct/Robo-DC-DC-Design/LM5143/LM5143_v1.0.kicad_pcb

## KiCad design LM5143/LM5143_v1.0.kicad_pcb (2026-10-31)

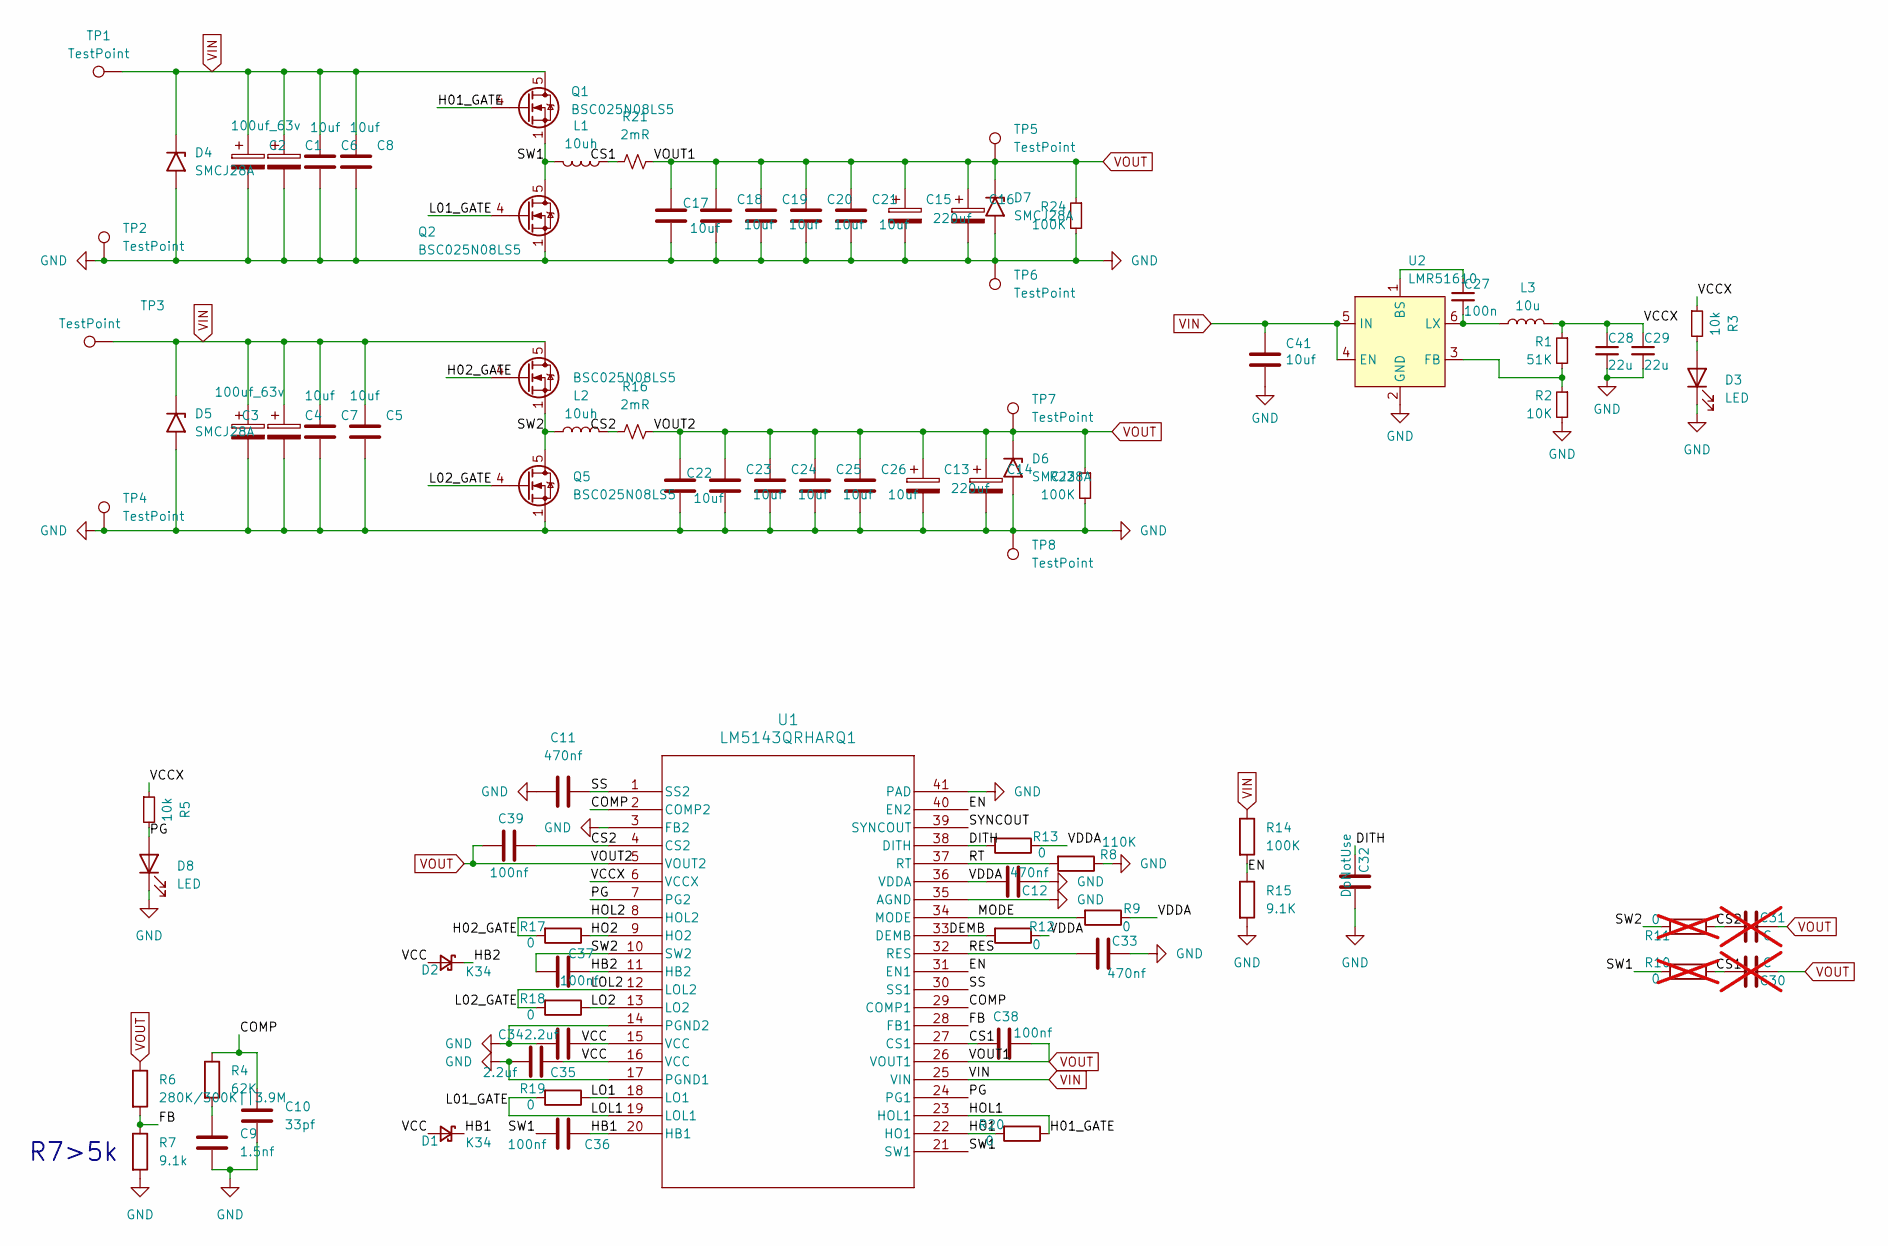
[picture p5: schematic LM5143_v1.0.kicad_sch]

Parts:
C1, C2, C3: 100uf_63v; CP_Radial_D8.0mm_P3.50mm
C4: 100uf_63V; CP_Radial_D8.0mm_P3.50mm
C5, C6, C7, C8: 10uf; C_1210_3225Metric
C9: 1.5nf; C_0603_1608Metric
C10: 33pf; C_0603_1608Metric
C11, C12, C33: 470nf; C_0603_1608Metric
C13, C14, C15, C16: 220uf; CP_Radial_D8.0mm_P3.50mm
C17, C18, C19, C20, C21, C22, C23, C24, C25, C26, C41: 10uf; C_1206_3216Metric
C27: 100n; C_0603_1608Metric
C28, C29: 22u; C_0805_2012Metric
C30, C31: C; C_0603_1608Metric; not fitted
C32: DoNotUse; C_0603_1608Metric
C34, C35: 2.2uf; C_0603_1608Metric
C36, C37, C38, C39: 100nf; C_0603_1608Metric
D1, D2: K34; D_SOD-323_HandSoldering
D3, D8: LED; LED_0603_1608Metric
D4, D5, D6, D7: SMCJ28A; D_SMA
L1, L2: 10uh; PQ20__
L3: 10u; L_Sunlord_MWSA0402S
Q1, Q2, Q4, Q5: BSC025N08LS5; TDSON-8-1
R1: 51K; R_0603_1608Metric
R2: 10K; R_0603_1608Metric
R3, R5: 10k; R_0603_1608Metric
R4: 62K; R_0603_1608Metric
R6: 280K/300K||3.9M; R_0603_1608Metric
R7: 9.1k; R_0603_1608Metric
R8: 110K; R_0603_1608Metric
R9, R12, R13, R17, R18, R19, R20: 0; R_0603_1608Metric
R10, R11: 0; R_0603_1608Metric; not fitted
R14, R23, R24: 100K; R_0603_1608Metric
R15: 9.1K; R_0603_1608Metric
R16, R21: 2mR; R_2512_6332Metric
TP1, TP2, TP3, TP4, TP5, TP6, TP7, TP8: TestPoint; TestPoint_Pad_3.0x3.0mm
U1: LM5143QRHARQ1; VQFN40_RHA_TEX
U2: LMR51610; SOT-23-6

Connections:
/COMP: C10.1, R4.1, U1.2 (COMP2), U1.29 (COMP1)
/CS1: C30.2, C38.1, L1.1, R10.1, R21.1, U1.27 (CS1)
/CS2: C31.2, C39.2, L2.2, R11.1, R16.1, U1.4 (CS2)
/DEMB: R12.2, U1.33 (DEMB)
/DITH: C32.1, R13.2, U1.38 (DITH)
/EN: R14.2, R15.1, U1.31 (EN1), U1.40 (EN2)
/FB: R6.2, R7.1, U1.28 (FB1)
/H01_GATE: Q1.4 (G), R20.1, U1.23 (HOL1)
/H02_GATE: Q4.4 (G), R17.2, U1.8 (HOL2)
/HB1: C36.1, D1.1 (K), U1.20 (HB1)
/HB2: C37.2, D2.1 (K), U1.11 (HB2)
/HO1: R20.2, U1.22 (HO1)
/HO2: R17.1, U1.9 (HO2)
/L01_GATE: Q2.4 (G), R19.2, U1.19 (LOL1)
/L02_GATE: Q5.4 (G), R18.2, U1.12 (LOL2)
/LO1: R19.1, U1.18 (LO1)
/LO2: R18.1, U1.13 (LO2)
/MODE: R9.2, U1.34 (MODE)
/PG: D8.2 (A), R5.2, U1.7 (PG2), U1.24 (PG1)
/RES: C33.1, U1.32 (RES)
/RT: R8.2, U1.37 (RT)
/SS: C11.1, U1.1 (SS2), U1.30 (SS1)
/SW1: C36.2, L1.2, Q1.1 (S), Q1.2 (S), Q1.3 (S), Q2.5 (D), R10.2, U1.21 (SW1)
/SW2: C37.1, L2.1, Q4.1 (S), Q4.2 (S), Q4.3 (S), Q5.5 (D), R11.2, U1.10 (SW2)
/SYNCOUT: U1.39 (SYNCOUT)
/VCC: C34.1, C35.1, D1.2 (A), D2.2 (A), U1.15 (VCC), U1.16 (VCC)
/VCCX: C28.1, C29.1, L3.2, R1.1, R3.1, R5.1, U1.6 (VCCX)
/VDDA: C12.2, R9.1, R12.1, R13.1, U1.36 (VDDA)
GND: C1.2, C2.2, C3.2, C4.2, C5.2, C6.2, C7.2, C8.2, C9.2, C10.2, C11.2, C12.1, C13.2, C14.2, C15.2, C16.2, C17.2, C18.2, C19.2, C20.2, C21.2, C22.2, C23.2, C24.2, C25.2, C26.2, C28.2, C29.2, C32.2, C33.2, C34.2, C35.2, C41.2, D3.1 (K), D4.2 (A2), D5.2 (A2), D6.2 (A2), D7.2 (A2), D8.1 (K), Q2.1 (S), Q2.2 (S), Q2.3 (S), Q5.1 (S), Q5.2 (S), Q5.3 (S), R2.2, R7.2, R8.1, R15.2, R23.2, R24.2, TP2.1, TP4.1, TP6.1, TP8.1, U1.3 (FB2), U1.14 (PGND2), U1.17 (PGND1), U1.35 (AGND), U1.41 (PAD), U2.2 (GND)
unnamed: C9.1, R4.2
unnamed: D3.2 (A), R3.2
unnamed: C27.1, U2.1 (BS)
unnamed: R1.2, R2.1, U2.3 (FB)
unnamed: C27.2, L3.1, U2.6 (LX)
VIN: C1.1, C2.1, C3.1, C4.1, C5.1, C6.1, C7.1, C8.1, C41.1, D4.1 (A1), D5.1 (A1), Q1.5 (D), Q4.5 (D), R14.1, TP1.1, TP3.1, U1.25 (VIN), U2.4 (EN), U2.5 (IN)
VOUT: C13.1, C14.1, C15.1, C16.1, C17.1, C18.1, C19.1, C20.1, C21.1, C22.1, C23.1, C24.1, C25.1, C26.1, C30.1, C31.1, C38.2, C39.1, D6.1 (A1), D7.1 (A1), R6.1, R16.2, R21.2, R23.1, R24.1, TP5.1, TP7.1, U1.5 (VOUT2), U1.26 (VOUT1)

Notes on the sheet:
R7>5k

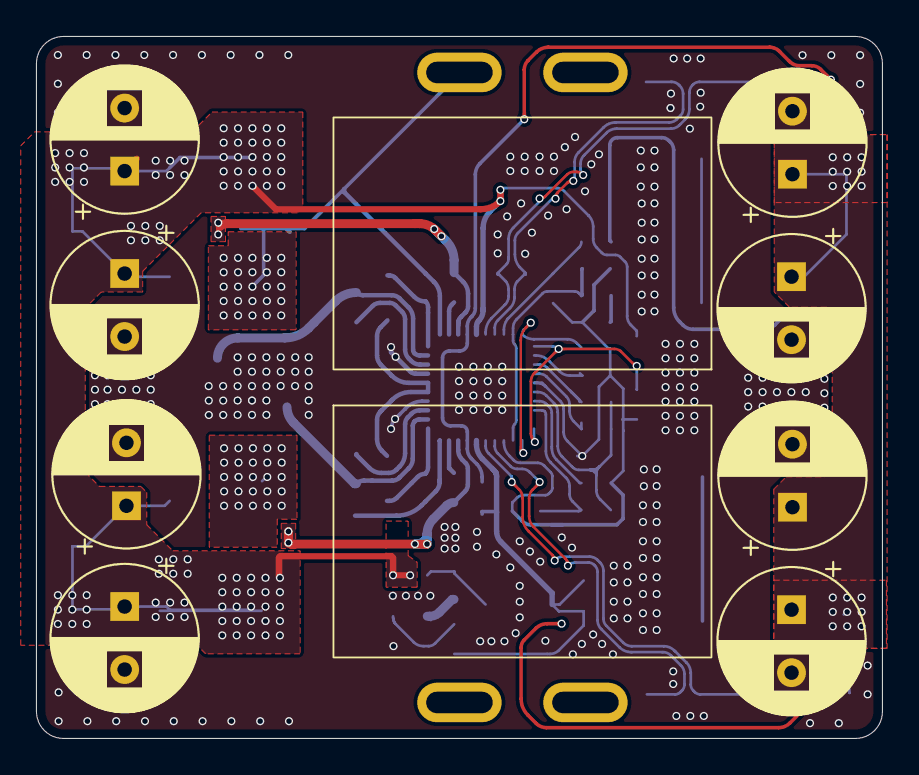
[picture p6: board LM5143_v1.0.kicad_pcb from above]

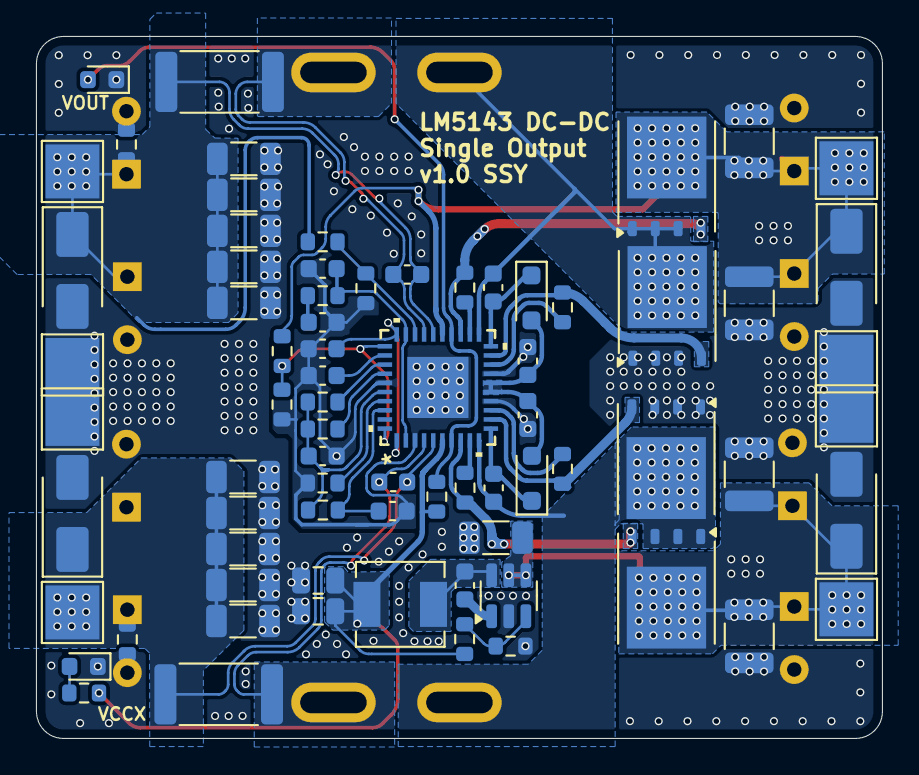
[picture p7: board LM5143_v1.0.kicad_pcb from below]

Board: 2 copper layers, 47.0 x 39.0 mm, 84 parts (74 on the bottom side), 35 nets.
