syacct/Robo-DC-DC-Design/LM5176/LM5176.kicad_pcb

## KiCad design LM5176/LM5176.kicad_pcb (2026-10-31)

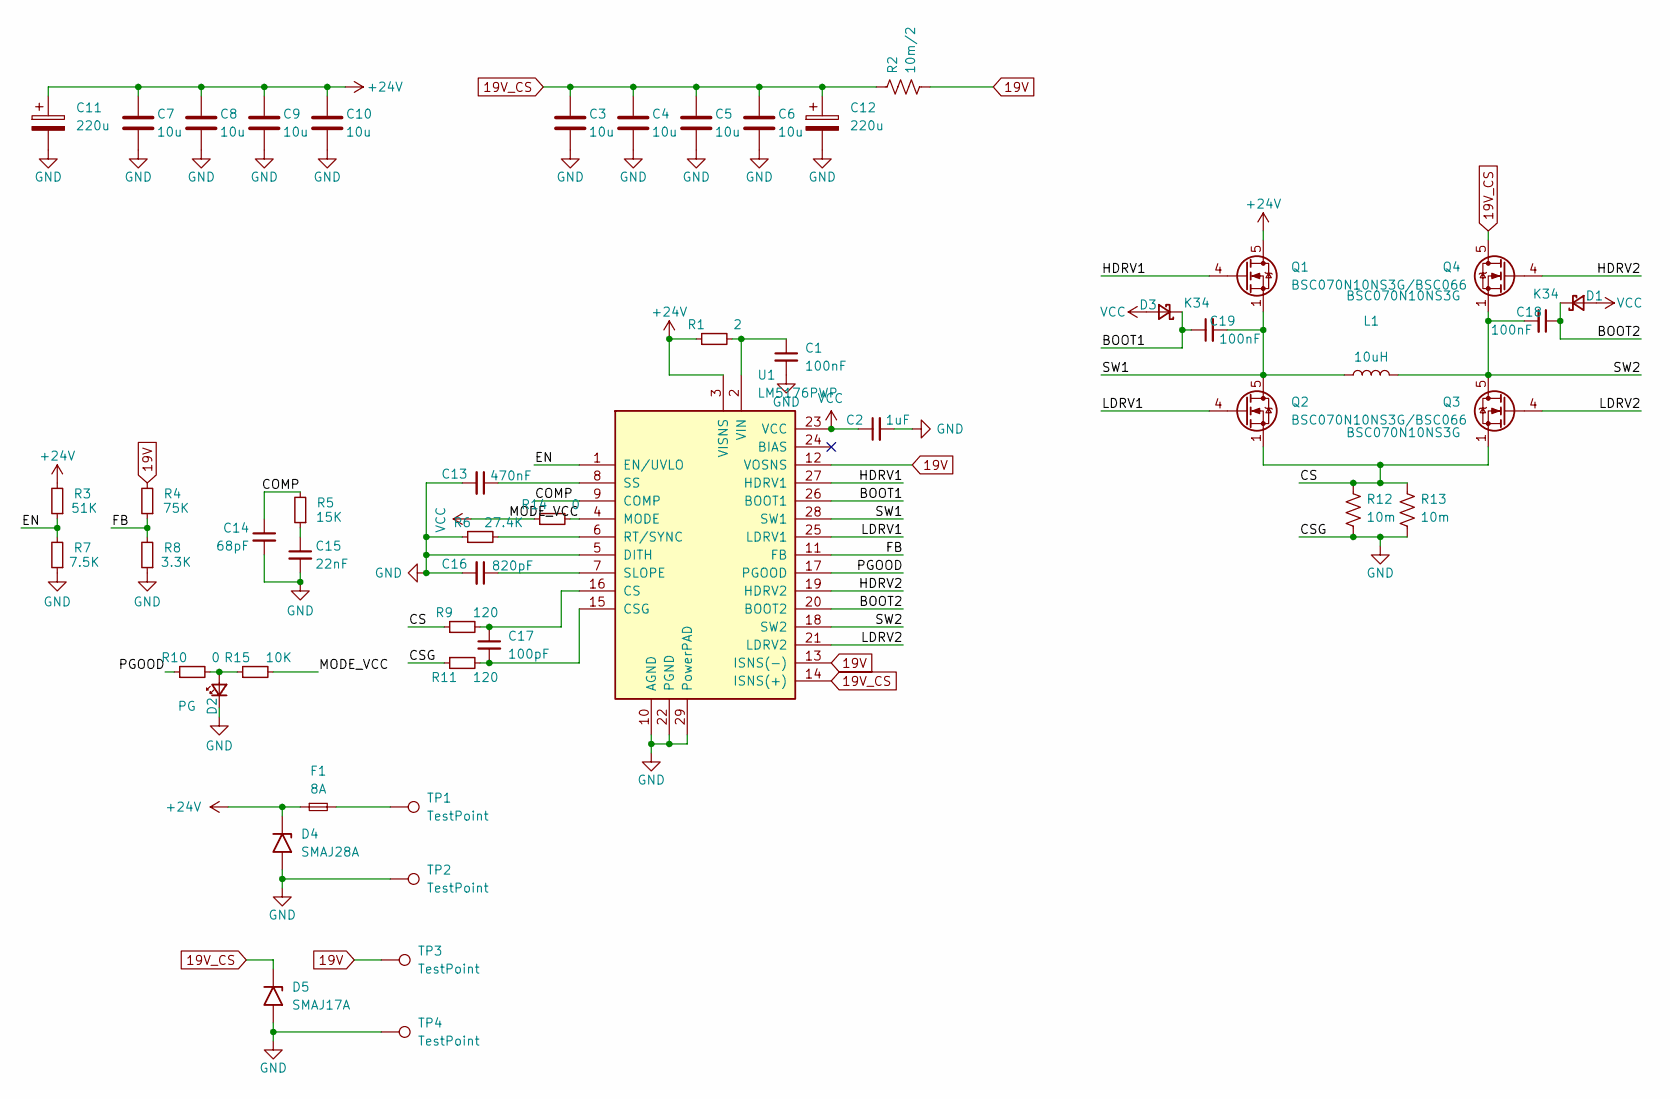
[picture p8: schematic LM5176.kicad_sch]

Parts:
C1, C18, C19: 100nF; C_0603_1608Metric
C2: 1uF; C_0603_1608Metric
C3, C4, C5, C6, C7, C8, C9, C10: 10u; C_1206_3216Metric
C11: 220u; C_D8xH12mm_Hor
C12: 220u; C_D8xH12mm_Hor_Flip
C13: 470nF; C_0603_1608Metric
C14: 68pF; C_0603_1608Metric
C15: 22nF; C_0603_1608Metric
C16: 820pF; C_0603_1608Metric
C17: 100pF; C_0603_1608Metric
D1, D3: K34; D_SOD-323_HandSoldering
D2: PG; LED_0603_1608Metric
D4: SMAJ28A; D_SMA
D5: SMAJ17A; D_SMA
F1: 8A; Fuse_1206_3216Metric
L1: 10uH; L_Bourns_SRP1770TA_16.9x16.9mm
Q1, Q2: BSC070N10NS3G/BSC066; TDSON-8-1
Q3, Q4: BSC070N10NS3G; TDSON-8-1
R1: 2; R_0603_1608Metric
R2: 10m/2; R_1206_3216Metric
R3: 51K; R_0603_1608Metric
R4: 75K; R_0603_1608Metric
R5: 15K; R_0603_1608Metric
R6: 27.4K; R_0603_1608Metric
R7: 7.5K; R_0603_1608Metric
R8: 3.3K; R_0603_1608Metric
R9, R11: 120; R_0603_1608Metric
R10, R14: 0; R_0603_1608Metric
R12, R13: 10m; R_1206_3216Metric
R15: 10K; R_0603_1608Metric
TP1, TP2, TP3, TP4: TestPoint; TestPoint_Pad_3.0x3.0mm
U1: LM5176PWP; HTSSOP-28-1EP_4.4x9.7mm_P0.65mm_EP3.4x9.5mm_ThermalVias

Connections:
19V: R2.2, R4.2, TP3.1, U1.12 (VOSNS), U1.13 (ISNS(-))
19V_CS: C3.1, C4.1, C5.1, C6.1, C12.1, D5.1 (A1), Q4.5 (D), R2.1, U1.14 (ISNS(+))
+24V: C7.1, C8.1, C9.1, C10.1, C11.1, D4.1 (A1), F1.1, Q1.5 (D), R1.1, R3.2, U1.3 (VISNS)
/BOOT1: C19.1, D3.1 (K), U1.26 (BOOT1)
/BOOT2: C18.1, D1.1 (K), U1.20 (BOOT2)
/COMP: C14.1, R5.2, U1.9 (COMP)
/CS: Q2.1 (S), Q2.2 (S), Q2.3 (S), Q3.1 (S), Q3.2 (S), Q3.3 (S), R9.1, R12.1, R13.1
/EN: R3.1, R7.2, U1.1 (EN/UVLO)
/FB: R4.1, R8.2, U1.11 (FB)
/HDRV1: Q1.4 (G), U1.27 (HDRV1)
/HDRV2: Q4.4 (G), U1.19 (HDRV2)
/LDRV1: Q2.4 (G), U1.25 (LDRV1)
/LDRV2: Q3.4 (G), U1.21 (LDRV2)
/MODE_VCC: R14.2, R15.2, U1.4 (MODE)
/PGOOD: R10.1, U1.17 (PGOOD)
/SW1: C19.2, L1.1, Q1.1 (S), Q1.2 (S), Q1.3 (S), Q2.5 (D), U1.28 (SW1)
/SW2: C18.2, L1.2, Q3.5 (D), Q4.1 (S), Q4.2 (S), Q4.3 (S), U1.18 (SW2)
GND: C1.2, C2.2, C3.2, C4.2, C5.2, C6.2, C7.2, C8.2, C9.2, C10.2, C11.2, C12.2, C13.2, C14.2, C15.2, C16.2, D2.1 (K), D4.2 (A2), D5.2 (A2), R6.1, R7.1, R8.1, R11.1, R12.2, R13.2, TP2.1, TP4.1, U1.5 (DITH), U1.10 (AGND), U1.22 (PGND), U1.29 (PowerPAD)
unnamed: C15.1, R5.1
unnamed: D2.2 (A), R10.2, R15.1
unnamed: F1.2, TP1.1
unnamed: C17.1, R9.2, U1.16 (CS)
unnamed: C17.2, R11.2, U1.15 (CSG)
unnamed: R6.2, U1.6 (RT/SYNC)
unnamed: C16.1, U1.7 (SLOPE)
unnamed: C13.1, U1.8 (SS)
unnamed: C1.1, R1.2, U1.2 (VIN)
VCC: C2.1, D1.2 (A), D3.2 (A), R14.1, U1.23 (VCC)

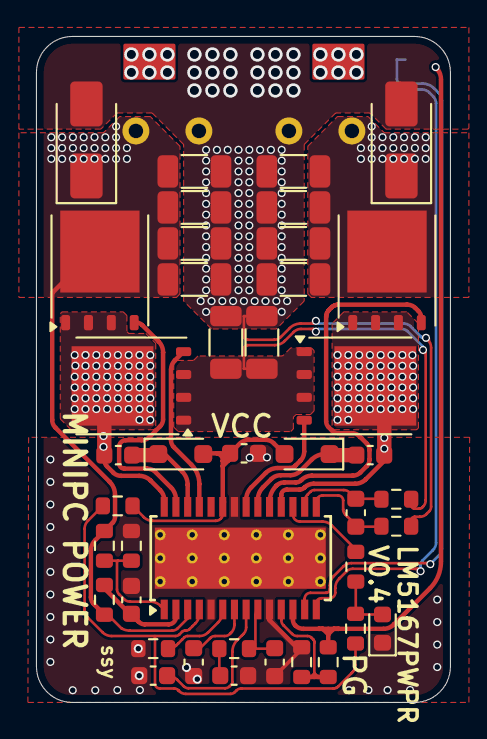
[picture p9: board LM5176.kicad_pcb from above]

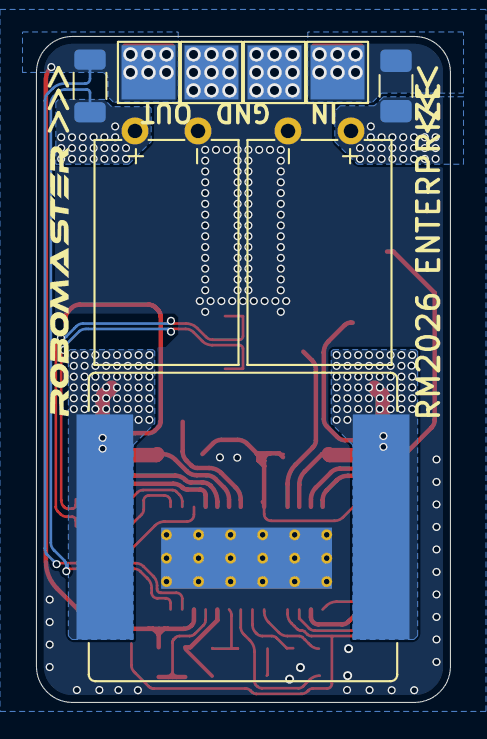
[picture p10: board LM5176.kicad_pcb from below]

Board: 2 copper layers, 23.0 x 37.0 mm, 50 parts (9 on the bottom side), 28 nets.
